Cao1014/2022_Smart_Car/README.md

# 2022 Smart Car
This repository includes the electrical designs of a smart car designed by in 2022.

(Note: _Computer Vision_ is not within the scope, sorry &#x1F915;)  
## Software:   
_Altium Designer_ 22.0.2 with student license  
_MDK-ARM 5.29.0.0_  default compiler version 5
## The whole design
Overall design of the car

 &nbsp; &nbsp; 

## Brushed DC Motor Control

#### Circuit Description

Brushed DC motor are commonly used in industrial applications such as robots, valves and healthcare equipment. When only one direction of rotation is required, a single switch topology with PWM modulation can be used to vary the voltage applied to the motor, and thus to control its speed. When positioning is required or when both directions of rotation are needed a full H-bridge with PWM control is used.  
This design adopts the _H-bridge_ structure to drive the brushed DC motor.
绘图2

**The circuit schematics and PCB layout are in the Altium folder.**  
**ESC codes are in the Codes folder.**
## Task Implementation

Obtaining the speed and angle of the car is the premise to realize the car's autonomous line tracking. The collected data form sensors are used in conjunction with the PID algorithm based on STM32. Through calculation, the control data via the PWM will be sent to the motor electronic speed controller to control speed of the motors. The whole mechanism is shown below

  

绘图1

**The circuit schematics and PCB layout are in the Altium folder.**  
**Codes for all patios are in the Codes folder.**
