Cao1014/2022_Smart_Car/(list of files, drawings)

Other design files:
Brushed_DCMotor_Control/Altium/MINI_ESC_G0.PrjPcb
Brushed_DCMotor_Control/Altium/MINI_ESC_V1.0.SchDoc
Tasks_Implementation/Altium/CHAS_CTRL_G0.PrjPcb
Tasks_Implementation/Altium/Main_Control_V1.1.SchDoc
