Cao1014/2022_Smart_Car/Tasks_Implementation/Codes/CHAS_G0_V2_Patio1/Core/Src/main.c

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
/* Includes ------------------------------------------------------------------*/
#include "main.h"
#include "rtc.h"
#include "spi.h"
#include "tim.h"
#include "usart.h"
#include "gpio.h"

/* USER CODE BEGIN Includes */
#include "usonic.h"
#include "motion.h"
#include "my_robot.h"
#include "nrf.h"
#include "elapse.h"
#include "stdio.h"
/* USER CODE END Includes */


/* USER CODE BEGIN PV */
extern IMU MyIMU;
extern ESC_COM G0;
extern NRF_COM MyNRF;
extern uint8_t Rx3Buffer[IMUBUFFERSIZE];
extern uint8_t Rx2Buffer[CVBUFFERSIZE];
extern uint8_t Rx1Buffer[BLBUFFERSIZE]; 

extern int16_t nrf_trans_cmd[7];         //转换后数据
extern uint8_t button[26];									//按键 

/* USER CODE END PV */

void SystemClock_Config(void);
/* USER CODE BEGIN 0 */
#ifdef __GNUC__
  /* With GCC/RAISONANCE, small printf (option LD Linker->Libraries->Small printf
     set to 'Yes') calls __io_putchar() */
  #define PUTCHAR_PROTOTYPE int __io_putchar(int ch)
#else
  #define PUTCHAR_PROTOTYPE int fputc(int ch, FILE *f)
#endif /* __GNUC__ */
/**
  * @brief  Retargets the C library printf function to the USART.
  * @param  None
  * @retval None
  */
PUTCHAR_PROTOTYPE
{
  /* Place your implementation of fputc here */
  /* e.g. write a character to the EVAL_COM1 and Loop until the end of transmission */
  HAL_UART_Transmit(&huart1, (uint8_t *)&ch, 1, 0xFFFF);//更具实际情况更改驱动
 
  return ch;
}
/* USER CODE END 0 */

/**
  * @brief  The application entry point.
  * @retval int
  */
int main(void)
{
  /* MCU Configuration--------------------------------------------------------*/

  /* Reset of all peripherals, Initializes the Flash interface and the Systick. */
   HAL_Init();

  /* Configure the system clock */
  SystemClock_Config();

  /* Initialize all configured peripherals */
  MX_GPIO_Init();
  MX_RTC_Init();
  MX_SPI2_Init();
  MX_TIM3_Init();
  MX_TIM14_Init();
  MX_TIM15_Init();
  MX_TIM16_Init();
  MX_TIM17_Init();
  MX_USART1_UART_Init();
  MX_USART2_UART_Init();
  MX_USART3_UART_Init();
  MX_USART4_UART_Init();
  MX_TIM7_Init();
  MX_TIM6_Init();
  /* USER CODE BEGIN 2 */
	IMU_Init();
	CV_init();
	LL_mDelay(50);
	TIM14->CCR1 = 5;//开启超声波
	TIM15->CCR2 = 55;
	
	IMU_Command(ANGLE_INIT);
	Angle_init(); //开启角度环
	nrf_init();	
//	RTC_Init(); //等待电脑数据

  /* USER CODE END 2 */

  /* Infinite loop */
  /* USER CODE BEGIN WHILE */
  while (1)
  {
    /* USER CODE END WHILE */

    /* USER CODE BEGIN 3 */
		IMU_Receive(Rx3Buffer);
		Mean_Filter();
		Car_Drive(MyNRF.Mode);

  }
  /* USER CODE END 3 */
}

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
