Cao1014/2022_Smart_Car/Tasks_Implementation/Codes/CHAS_G0_V2_Patio1/CHAS_G0_V2_Patio1.ioc

Mcu.UserName=STM32G070CBTx
PA0.Signal=USART4_TX
PA1.Signal=USART4_RX
PA13.Signal=SYS_SWDIO
PA14-BOOT0.Signal=SYS_SWCLK
PA2.Signal=USART2_TX
PA3.Signal=USART2_RX
PA4.Signal=S_TIM14_CH1
PA6.Signal=S_TIM3_CH1
PA7.Signal=S_TIM3_CH2
PB0.Signal=S_TIM3_CH3
PB1.Signal=S_TIM3_CH4
PB10.Signal=SPI2_SCK
PB11.Signal=SPI2_MOSI
PB12.GPIO_Label=NRF_IRQ
PB12.Signal=GPIO_Input
PB13.GPIO_Label=NRF_CE
PB13.Signal=GPIO_Output
PB14.GPIO_Label=NRF_CS
PB14.Signal=GPIO_Output
PB15.Signal=S_TIM15_CH2
PB2.Signal=SPI2_MISO
PB6.Signal=USART1_TX
PB7.Signal=USART1_RX
PB8.Signal=USART3_TX
PB9.Signal=USART3_RX
PD0.Signal=S_TIM16_CH1
PD1.Signal=S_TIM17_CH1
