Cao1014/2022_Smart_Car/Tasks_Implementation/Codes/CHAS_G0_V2_Patio1/Core/Inc/main.h

#define NRF_IRQ_Pin LL_GPIO_PIN_12
#define NRF_IRQ_GPIO_Port GPIOB
#define NRF_CE_Pin LL_GPIO_PIN_13
#define NRF_CE_GPIO_Port GPIOB
#define NRF_CS_Pin LL_GPIO_PIN_14
#define NRF_CS_GPIO_Port GPIOB
