Cao1014/2022_Smart_Car/Tasks_Implementation/Codes/CHAS_G0_V2_Patio1/Core/Src/tim.c

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
/* Includes ------------------------------------------------------------------*/
#include "tim.h"

/* TIM3 init function */
void MX_TIM3_Init(void)
{

  LL_TIM_InitTypeDef TIM_InitStruct = {0};
  LL_TIM_OC_InitTypeDef TIM_OC_InitStruct = {0};

  LL_RCC_LSE_SetDriveCapability(LL_RCC_LSEDRIVE_LOW);

  LL_GPIO_InitTypeDef GPIO_InitStruct = {0};
  /* Peripheral clock enable */
  LL_APB1_GRP1_EnableClock(LL_APB1_GRP1_PERIPH_TIM3);

  TIM_InitStruct.Prescaler = 639;
  TIM_InitStruct.CounterMode = LL_TIM_COUNTERMODE_UP;
  TIM_InitStruct.Autoreload = 999;
  TIM_InitStruct.ClockDivision = LL_TIM_CLOCKDIVISION_DIV1;
  LL_TIM_Init(TIM3, &TIM_InitStruct);
  LL_TIM_DisableARRPreload(TIM3);
  LL_TIM_OC_EnablePreload(TIM3, LL_TIM_CHANNEL_CH1);
  TIM_OC_InitStruct.OCMode = LL_TIM_OCMODE_PWM1;
  TIM_OC_InitStruct.OCState = LL_TIM_OCSTATE_DISABLE;
  TIM_OC_InitStruct.OCNState = LL_TIM_OCSTATE_DISABLE;
  TIM_OC_InitStruct.CompareValue = 0;
  TIM_OC_InitStruct.OCPolarity = LL_TIM_OCPOLARITY_HIGH;
  LL_TIM_OC_Init(TIM3, LL_TIM_CHANNEL_CH1, &TIM_OC_InitStruct);
  LL_TIM_OC_DisableFast(TIM3, LL_TIM_CHANNEL_CH1);
  LL_TIM_OC_EnablePreload(TIM3, LL_TIM_CHANNEL_CH2);
  LL_TIM_OC_Init(TIM3, LL_TIM_CHANNEL_CH2, &TIM_OC_InitStruct);
  LL_TIM_OC_DisableFast(TIM3, LL_TIM_CHANNEL_CH2);
  LL_TIM_OC_EnablePreload(TIM3, LL_TIM_CHANNEL_CH3);
  LL_TIM_OC_Init(TIM3, LL_TIM_CHANNEL_CH3, &TIM_OC_InitStruct);
  LL_TIM_OC_DisableFast(TIM3, LL_TIM_CHANNEL_CH3);
  LL_TIM_OC_EnablePreload(TIM3, LL_TIM_CHANNEL_CH4);
  LL_TIM_OC_Init(TIM3, LL_TIM_CHANNEL_CH4, &TIM_OC_InitStruct);
  LL_TIM_OC_DisableFast(TIM3, LL_TIM_CHANNEL_CH4);
  LL_TIM_SetTriggerOutput(TIM3, LL_TIM_TRGO_RESET);
  LL_TIM_DisableMasterSlaveMode(TIM3);
  /* USER CODE BEGIN TIM3_Init 2 */
	LL_TIM_CC_EnableChannel(TIM3,LL_TIM_CHANNEL_CH1);
	LL_TIM_CC_EnableChannel(TIM3,LL_TIM_CHANNEL_CH2);
	LL_TIM_CC_EnableChannel(TIM3,LL_TIM_CHANNEL_CH3);
	LL_TIM_CC_EnableChannel(TIM3,LL_TIM_CHANNEL_CH4);
	
	LL_TIM_EnableCounter(TIM3);
	LL_TIM_EnableAllOutputs(TIM3);
	
  /* USER CODE END TIM3_Init 2 */
  LL_IOP_GRP1_EnableClock(LL_IOP_GRP1_PERIPH_GPIOA);
  LL_IOP_GRP1_EnableClock(LL_IOP_GRP1_PERIPH_GPIOB);
    /**TIM3 GPIO Configuration
    PA6     ------> TIM3_CH1
    PA7     ------> TIM3_CH2
    PB0     ------> TIM3_CH3
    PB1     ------> TIM3_CH4
    */
  GPIO_InitStruct.Pin = LL_GPIO_PIN_6;
  GPIO_InitStruct.Mode = LL_GPIO_MODE_ALTERNATE;
  GPIO_InitStruct.Speed = LL_GPIO_SPEED_FREQ_LOW;
  GPIO_InitStruct.OutputType = LL_GPIO_OUTPUT_PUSHPULL;
  GPIO_InitStruct.Pull = LL_GPIO_PULL_NO;
  GPIO_InitStruct.Alternate = LL_GPIO_AF_1;
  LL_GPIO_Init(GPIOA, &GPIO_InitStruct);

  GPIO_InitStruct.Pin = LL_GPIO_PIN_7;
  GPIO_InitStruct.Mode = LL_GPIO_MODE_ALTERNATE;
  GPIO_InitStruct.Speed = LL_GPIO_SPEED_FREQ_LOW;
  GPIO_InitStruct.OutputType = LL_GPIO_OUTPUT_PUSHPULL;
  GPIO_InitStruct.Pull = LL_GPIO_PULL_NO;
  GPIO_InitStruct.Alternate = LL_GPIO_AF_1;
  LL_GPIO_Init(GPIOA, &GPIO_InitStruct);

  GPIO_InitStruct.Pin = LL_GPIO_PIN_0;
  GPIO_InitStruct.Mode = LL_GPIO_MODE_ALTERNATE;
  GPIO_InitStruct.Speed = LL_GPIO_SPEED_FREQ_LOW;
  GPIO_InitStruct.OutputType = LL_GPIO_OUTPUT_PUSHPULL;
  GPIO_InitStruct.Pull = LL_GPIO_PULL_NO;
  GPIO_InitStruct.Alternate = LL_GPIO_AF_1;
  LL_GPIO_Init(GPIOB, &GPIO_InitStruct);

  GPIO_InitStruct.Pin = LL_GPIO_PIN_1;
  GPIO_InitStruct.Mode = LL_GPIO_MODE_ALTERNATE;
  GPIO_InitStruct.Speed = LL_GPIO_SPEED_FREQ_LOW;
  GPIO_InitStruct.OutputType = LL_GPIO_OUTPUT_PUSHPULL;
  GPIO_InitStruct.Pull = LL_GPIO_PULL_NO;
  GPIO_InitStruct.Alternate = LL_GPIO_AF_1;
  LL_GPIO_Init(GPIOB, &GPIO_InitStruct);

}
/* TIM6 init function */
void MX_TIM6_Init(void)
{

  LL_TIM_InitTypeDef TIM_InitStruct = {0};

  LL_RCC_LSE_SetDriveCapability(LL_RCC_LSEDRIVE_LOW);

  /* Peripheral clock enable */
  LL_APB1_GRP1_EnableClock(LL_APB1_GRP1_PERIPH_TIM6);

  /* TIM6 interrupt Init */
  NVIC_SetPriority(TIM6_IRQn, 0);
  NVIC_EnableIRQ(TIM6_IRQn);

  TIM_InitStruct.Prescaler = 6399;
  TIM_InitStruct.CounterMode = LL_TIM_COUNTERMODE_UP;
  TIM_InitStruct.Autoreload = 999;
  LL_TIM_Init(TIM6, &TIM_InitStruct);
  LL_TIM_DisableARRPreload(TIM6);
  LL_TIM_SetTriggerOutput(TIM6, LL_TIM_TRGO_RESET);
  LL_TIM_DisableMasterSlaveMode(TIM6);
  /* USER CODE BEGIN TIM6_Init 2 */
	LL_TIM_EnableIT_UPDATE(TIM6);//开启中断
	LL_TIM_EnableCounter(TIM6);
  /* USER CODE END TIM6_Init 2 */

}
/* TIM7 init function */
void MX_TIM7_Init(void)
{

  LL_TIM_InitTypeDef TIM_InitStruct = {0};

  LL_RCC_LSE_SetDriveCapability(LL_RCC_LSEDRIVE_LOW);

  /* Peripheral clock enable */
  LL_APB1_GRP1_EnableClock(LL_APB1_GRP1_PERIPH_TIM7);

  /* TIM7 interrupt Init */
  NVIC_SetPriority(TIM7_IRQn, 0);
  NVIC_EnableIRQ(TIM7_IRQn);

  TIM_InitStruct.Prescaler = 639;
  TIM_InitStruct.CounterMode = LL_TIM_COUNTERMODE_UP;
  TIM_InitStruct.Autoreload = 1999;
  LL_TIM_Init(TIM7, &TIM_InitStruct);
  LL_TIM_DisableARRPreload(TIM7);
  LL_TIM_SetTriggerOutput(TIM7, LL_TIM_TRGO_RESET);
  LL_TIM_DisableMasterSlaveMode(TIM7);
  /* USER CODE BEGIN TIM7_Init 2 */
	
	LL_TIM_EnableCounter(TIM7);
	
  /* USER CODE END TIM7_Init 2 */

}
/* TIM14 init function */
void MX_TIM14_Init(void)
{

  LL_TIM_InitTypeDef TIM_InitStruct = {0};
  LL_TIM_OC_InitTypeDef TIM_OC_InitStruct = {0};

  LL_RCC_LSE_SetDriveCapability(LL_RCC_LSEDRIVE_LOW);

  LL_GPIO_InitTypeDef GPIO_InitStruct = {0};
  /* Peripheral clock enable */
  LL_APB2_GRP1_EnableClock(LL_APB2_GRP1_PERIPH_TIM14);

  /* TIM14 interrupt Init */
  NVIC_SetPriority(TIM14_IRQn, 2);
  NVIC_EnableIRQ(TIM14_IRQn);

  TIM_InitStruct.Prescaler = 639;
  TIM_InitStruct.CounterMode = LL_TIM_COUNTERMODE_UP;
  TIM_InitStruct.Autoreload = 6999;
  TIM_InitStruct.ClockDivision = LL_TIM_CLOCKDIVISION_DIV1;
  LL_TIM_Init(TIM14, &TIM_InitStruct);
  LL_TIM_DisableARRPreload(TIM14);
  LL_TIM_OC_EnablePreload(TIM14, LL_TIM_CHANNEL_CH1);
  TIM_OC_InitStruct.OCMode = LL_TIM_OCMODE_PWM1;
  TIM_OC_InitStruct.OCState = LL_TIM_OCSTATE_DISABLE;
  TIM_OC_InitStruct.OCNState = LL_TIM_OCSTATE_DISABLE;
  TIM_OC_InitStruct.CompareValue = 0;
  TIM_OC_InitStruct.OCPolarity = LL_TIM_OCPOLARITY_HIGH;
  LL_TIM_OC_Init(TIM14, LL_TIM_CHANNEL_CH1, &TIM_OC_InitStruct);
  LL_TIM_OC_DisableFast(TIM14, LL_TIM_CHANNEL_CH1);
  /* USER CODE BEGIN TIM14_Init 2 */
	LL_TIM_CC_EnableChannel(TIM14,LL_TIM_CHANNEL_CH1);
	
	if (LL_TIM_CC_IsEnabledChannel(TIM14, LL_TIM_CHANNEL_CH1) != 01U)
  {
    /* PWM Generation Error */
    Error_Handler();
  }
	
	LL_TIM_EnableCounter(TIM14);
	LL_TIM_EnableAllOutputs(TIM14);
	
  /* USER CODE END TIM14_Init 2 */
  LL_IOP_GRP1_EnableClock(LL_IOP_GRP1_PERIPH_GPIOA);
    /**TIM14 GPIO Configuration
    PA4     ------> TIM14_CH1
    */
  GPIO_InitStruct.Pin = LL_GPIO_PIN_4;
  GPIO_InitStruct.Mode = LL_GPIO_MODE_ALTERNATE;
  GPIO_InitStruct.Speed = LL_GPIO_SPEED_FREQ_LOW;
  GPIO_InitStruct.OutputType = LL_GPIO_OUTPUT_PUSHPULL;
  GPIO_InitStruct.Pull = LL_GPIO_PULL_NO;
  GPIO_InitStruct.Alternate = LL_GPIO_AF_4;
  LL_GPIO_Init(GPIOA, &GPIO_InitStruct);

}
/* TIM15 init function */
void MX_TIM15_Init(void)
{

  LL_TIM_InitTypeDef TIM_InitStruct = {0};
  LL_TIM_OC_InitTypeDef TIM_OC_InitStruct = {0};
  LL_TIM_BDTR_InitTypeDef TIM_BDTRInitStruct = {0};

  LL_RCC_LSE_SetDriveCapability(LL_RCC_LSEDRIVE_LOW);

  LL_GPIO_InitTypeDef GPIO_InitStruct = {0};
  /* Peripheral clock enable */
  LL_APB2_GRP1_EnableClock(LL_APB2_GRP1_PERIPH_TIM15);

  /* TIM15 interrupt Init */
  NVIC_SetPriority(TIM15_IRQn, 1);
  NVIC_EnableIRQ(TIM15_IRQn);

  TIM_InitStruct.Prescaler = 639;
  TIM_InitStruct.CounterMode = LL_TIM_COUNTERMODE_UP;
  TIM_InitStruct.Autoreload = 1999;
  TIM_InitStruct.ClockDivision = LL_TIM_CLOCKDIVISION_DIV1;
  TIM_InitStruct.RepetitionCounter = 0;
  LL_TIM_Init(TIM15, &TIM_InitStruct);
  LL_TIM_DisableARRPreload(TIM15);
  LL_TIM_OC_EnablePreload(TIM15, LL_TIM_CHANNEL_CH2);
  TIM_OC_InitStruct.OCMode = LL_TIM_OCMODE_PWM1;
  TIM_OC_InitStruct.OCState = LL_TIM_OCSTATE_DISABLE;
  TIM_OC_InitStruct.OCNState = LL_TIM_OCSTATE_DISABLE;
  TIM_OC_InitStruct.CompareValue = 0;
  TIM_OC_InitStruct.OCPolarity = LL_TIM_OCPOLARITY_HIGH;
  TIM_OC_InitStruct.OCNPolarity = LL_TIM_OCPOLARITY_HIGH;
  TIM_OC_InitStruct.OCIdleState = LL_TIM_OCIDLESTATE_LOW;
  TIM_OC_InitStruct.OCNIdleState = LL_TIM_OCIDLESTATE_LOW;
  LL_TIM_OC_Init(TIM15, LL_TIM_CHANNEL_CH2, &TIM_OC_InitStruct);
  LL_TIM_OC_DisableFast(TIM15, LL_TIM_CHANNEL_CH2);
  LL_TIM_SetTriggerOutput(TIM15, LL_TIM_TRGO_RESET);
  LL_TIM_DisableMasterSlaveMode(TIM15);
  TIM_BDTRInitStruct.OSSRState = LL_TIM_OSSR_DISABLE;
  TIM_BDTRInitStruct.OSSIState = LL_TIM_OSSI_DISABLE;
  TIM_BDTRInitStruct.LockLevel = LL_TIM_LOCKLEVEL_OFF;
  TIM_BDTRInitStruct.DeadTime = 0;
  TIM_BDTRInitStruct.BreakState = LL_TIM_BREAK_DISABLE;
  TIM_BDTRInitStruct.BreakPolarity = LL_TIM_BREAK_POLARITY_HIGH;
  TIM_BDTRInitStruct.BreakFilter = LL_TIM_BREAK_FILTER_FDIV1;
  TIM_BDTRInitStruct.AutomaticOutput = LL_TIM_AUTOMATICOUTPUT_DISABLE;
  LL_TIM_BDTR_Init(TIM15, &TIM_BDTRInitStruct);
  /* USER CODE BEGIN TIM15_Init 2 */
	LL_TIM_CC_EnableChannel(TIM15,LL_TIM_CHANNEL_CH2);
	
	LL_TIM_EnableCounter(TIM15);
	LL_TIM_EnableAllOutputs(TIM15);
	
	LL_TIM_EnableIT_UPDATE(TIM15);//开启中断
  /* USER CODE END TIM15_Init 2 */
  LL_IOP_GRP1_EnableClock(LL_IOP_GRP1_PERIPH_GPIOB);
    /**TIM15 GPIO Configuration
    PB15     ------> TIM15_CH2
    */
  GPIO_InitStruct.Pin = LL_GPIO_PIN_15;
  GPIO_InitStruct.Mode = LL_GPIO_MODE_ALTERNATE;
  GPIO_InitStruct.Speed = LL_GPIO_SPEED_FREQ_LOW;
  GPIO_InitStruct.OutputType = LL_GPIO_OUTPUT_PUSHPULL;
  GPIO_InitStruct.Pull = LL_GPIO_PULL_NO;
  GPIO_InitStruct.Alternate = LL_GPIO_AF_5;
  LL_GPIO_Init(GPIOB, &GPIO_InitStruct);

}
/* TIM16 init function */
void MX_TIM16_Init(void)
{

  LL_TIM_InitTypeDef TIM_InitStruct = {0};

  LL_GPIO_InitTypeDef GPIO_InitStruct = {0};

  LL_RCC_LSE_SetDriveCapability(LL_RCC_LSEDRIVE_LOW);

  /* Peripheral clock enable */
  LL_APB2_GRP1_EnableClock(LL_APB2_GRP1_PERIPH_TIM16);

  LL_IOP_GRP1_EnableClock(LL_IOP_GRP1_PERIPH_GPIOD);
  /**TIM16 GPIO Configuration
  PD0   ------> TIM16_CH1
  */
  GPIO_InitStruct.Pin = LL_GPIO_PIN_0;
  GPIO_InitStruct.Mode = LL_GPIO_MODE_ALTERNATE;
  GPIO_InitStruct.Speed = LL_GPIO_SPEED_FREQ_LOW;
  GPIO_InitStruct.OutputType = LL_GPIO_OUTPUT_PUSHPULL;
  GPIO_InitStruct.Pull = LL_GPIO_PULL_NO;
  GPIO_InitStruct.Alternate = LL_GPIO_AF_2;
  LL_GPIO_Init(GPIOD, &GPIO_InitStruct);

  /* TIM16 interrupt Init */
  NVIC_SetPriority(TIM16_IRQn, 1);
  NVIC_EnableIRQ(TIM16_IRQn);

  TIM_InitStruct.Prescaler = 639;
  TIM_InitStruct.CounterMode = LL_TIM_COUNTERMODE_UP;
  TIM_InitStruct.Autoreload = 8999;
  TIM_InitStruct.ClockDivision = LL_TIM_CLOCKDIVISION_DIV1;
  TIM_InitStruct.RepetitionCounter = 0;
  LL_TIM_Init(TIM16, &TIM_InitStruct);
  LL_TIM_DisableARRPreload(TIM16);
  LL_TIM_IC_SetActiveInput(TIM16, LL_TIM_CHANNEL_CH1, LL_TIM_ACTIVEINPUT_DIRECTTI);
  LL_TIM_IC_SetPrescaler(TIM16, LL_TIM_CHANNEL_CH1, LL_TIM_ICPSC_DIV1);
  LL_TIM_IC_SetFilter(TIM16, LL_TIM_CHANNEL_CH1, LL_TIM_IC_FILTER_FDIV32_N8);
  LL_TIM_IC_SetPolarity(TIM16, LL_TIM_CHANNEL_CH1, LL_TIM_IC_POLARITY_RISING);
  /* USER CODE BEGIN TIM16_Init 2 */
	LL_TIM_CC_EnableChannel(TIM16,LL_TIM_CHANNEL_CH1);
	
	LL_TIM_EnableIT_CC1(TIM16);
	LL_TIM_EnableCounter(TIM16);
	
	LL_TIM_ClearFlag_CC1(TIM16);
  /* USER CODE END TIM16_Init 2 */

}
/* TIM17 init function */
void MX_TIM17_Init(void)
{

  LL_TIM_InitTypeDef TIM_InitStruct = {0};

  LL_GPIO_InitTypeDef GPIO_InitStruct = {0};

  LL_RCC_LSE_SetDriveCapability(LL_RCC_LSEDRIVE_LOW);

  /* Peripheral clock enable */
  LL_APB2_GRP1_EnableClock(LL_APB2_GRP1_PERIPH_TIM17);

  LL_IOP_GRP1_EnableClock(LL_IOP_GRP1_PERIPH_GPIOD);
  /**TIM17 GPIO Configuration
  PD1   ------> TIM17_CH1
  */
  GPIO_InitStruct.Pin = LL_GPIO_PIN_1;
  GPIO_InitStruct.Mode = LL_GPIO_MODE_ALTERNATE;
  GPIO_InitStruct.Speed = LL_GPIO_SPEED_FREQ_LOW;
  GPIO_InitStruct.OutputType = LL_GPIO_OUTPUT_PUSHPULL;
  GPIO_InitStruct.Pull = LL_GPIO_PULL_NO;
  GPIO_InitStruct.Alternate = LL_GPIO_AF_2;
  LL_GPIO_Init(GPIOD, &GPIO_InitStruct);

  /* TIM17 interrupt Init */
  NVIC_SetPriority(TIM17_IRQn, 1);
  NVIC_EnableIRQ(TIM17_IRQn);

  TIM_InitStruct.Prescaler = 639;
  TIM_InitStruct.CounterMode = LL_TIM_COUNTERMODE_UP;
  TIM_InitStruct.Autoreload = 8999;
  TIM_InitStruct.ClockDivision = LL_TIM_CLOCKDIVISION_DIV1;
  TIM_InitStruct.RepetitionCounter = 0;
  LL_TIM_Init(TIM17, &TIM_InitStruct);
  LL_TIM_DisableARRPreload(TIM17);
  LL_TIM_IC_SetActiveInput(TIM17, LL_TIM_CHANNEL_CH1, LL_TIM_ACTIVEINPUT_DIRECTTI);
  LL_TIM_IC_SetPrescaler(TIM17, LL_TIM_CHANNEL_CH1, LL_TIM_ICPSC_DIV1);
  LL_TIM_IC_SetFilter(TIM17, LL_TIM_CHANNEL_CH1, LL_TIM_IC_FILTER_FDIV32_N8);
  LL_TIM_IC_SetPolarity(TIM17, LL_TIM_CHANNEL_CH1, LL_TIM_IC_POLARITY_RISING);
  /* USER CODE BEGIN TIM17_Init 2 */
	LL_TIM_CC_EnableChannel(TIM17,LL_TIM_CHANNEL_CH1);
	
	LL_TIM_EnableIT_CC1(TIM17);
	LL_TIM_EnableCounter(TIM17);
	
	LL_TIM_ClearFlag_CC1(TIM17);
  /* USER CODE END TIM17_Init 2 */

}
