Cao1014/2022_Smart_Car/Brushed_DCMotor_Control/Codes/MINI_ESC_G0/Core/Src/adc.c

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
/* Includes ------------------------------------------------------------------*/
#include "adc.h"

/* USER CODE BEGIN 0 */
short aADCxConvertedData[ADC_CONVERTED_DATA_BUFFER_SIZE];


/* USER CODE END 0 */

/* ADC1 init function */
void MX_ADC1_Init(void)
{

  LL_ADC_InitTypeDef ADC_InitStruct = {0};
  LL_ADC_REG_InitTypeDef ADC_REG_InitStruct = {0};

  LL_GPIO_InitTypeDef GPIO_InitStruct = {0};

  LL_RCC_SetADCClockSource(LL_RCC_ADC_CLKSOURCE_SYSCLK);

  /* Peripheral clock enable */
  LL_APB2_GRP1_EnableClock(LL_APB2_GRP1_PERIPH_ADC);

  LL_IOP_GRP1_EnableClock(LL_IOP_GRP1_PERIPH_GPIOA);
  /**ADC1 GPIO Configuration
  PA0   ------> ADC1_IN0
  */
  GPIO_InitStruct.Pin = LL_GPIO_PIN_0;
  GPIO_InitStruct.Mode = LL_GPIO_MODE_ANALOG;
  GPIO_InitStruct.Pull = LL_GPIO_PULL_NO;
  LL_GPIO_Init(GPIOA, &GPIO_InitStruct);

  /* ADC1 DMA Init */

  /* ADC1 Init */
  LL_DMA_SetPeriphRequest(DMA1, LL_DMA_CHANNEL_1, LL_DMAMUX_REQ_ADC1);

  LL_DMA_SetDataTransferDirection(DMA1, LL_DMA_CHANNEL_1, LL_DMA_DIRECTION_PERIPH_TO_MEMORY);

  LL_DMA_SetChannelPriorityLevel(DMA1, LL_DMA_CHANNEL_1, LL_DMA_PRIORITY_HIGH);

  LL_DMA_SetMode(DMA1, LL_DMA_CHANNEL_1, LL_DMA_MODE_CIRCULAR);

  LL_DMA_SetPeriphIncMode(DMA1, LL_DMA_CHANNEL_1, LL_DMA_PERIPH_NOINCREMENT);

  LL_DMA_SetMemoryIncMode(DMA1, LL_DMA_CHANNEL_1, LL_DMA_MEMORY_NOINCREMENT);

  LL_DMA_SetPeriphSize(DMA1, LL_DMA_CHANNEL_1, LL_DMA_PDATAALIGN_HALFWORD);

  LL_DMA_SetMemorySize(DMA1, LL_DMA_CHANNEL_1, LL_DMA_MDATAALIGN_HALFWORD);

  /* USER CODE BEGIN ADC1_Init 1 */
	
	 /* Set DMA transfer addresses of source and destination */
  LL_DMA_ConfigAddresses(DMA1,
                        LL_DMA_CHANNEL_1,
                         LL_ADC_DMA_GetRegAddr(ADC1, LL_ADC_DMA_REG_REGULAR_DATA),
                         (uint32_t)&aADCxConvertedData,
                         LL_DMA_DIRECTION_PERIPH_TO_MEMORY);
  
  /* Set DMA transfer size */
  LL_DMA_SetDataLength(DMA1,
                        LL_DMA_CHANNEL_1,
                       ADC_CONVERTED_DATA_BUFFER_SIZE);	
	
//	LL_DMA_SetDataLength(DMA1,LL_DMA_CHANNEL_1,ADC_CONVERTED_DATA_BUFFER_SIZE);
//	LL_DMA_SetPeriphAddress(DMA1,LL_DMA_CHANNEL_1,LL_ADC_DMA_GetRegAddr(ADC1,LL_ADC_DMA_REG_REGULAR_DATA));
//	LL_DMA_SetMemoryAddress(DMA1,LL_DMA_CHANNEL_1,(uint32_t)aADCxConvertedData);
	
	/*## Activation of DMA #####################################################*/
  /* Enable the DMA transfer */

  LL_DMA_EnableChannel(DMA1,LL_DMA_CHANNEL_1);
  /* USER CODE END ADC1_Init 1 */

  /** Configure the global features of the ADC (Clock, Resolution, Data Alignment and number of conversion)
  */

   #define ADC_CHANNEL_CONF_RDY_TIMEOUT_MS ( 1U)
   #if (USE_TIMEOUT == 1)
   uint32_t Timeout ; /* Variable used for Timeout management */
   #endif /* USE_TIMEOUT */

  ADC_InitStruct.Clock = LL_ADC_CLOCK_SYNC_PCLK_DIV2;
  ADC_InitStruct.Resolution = LL_ADC_RESOLUTION_12B;
  ADC_InitStruct.DataAlignment = LL_ADC_DATA_ALIGN_RIGHT;
  ADC_InitStruct.LowPowerMode = LL_ADC_LP_MODE_NONE;
  LL_ADC_Init(ADC1, &ADC_InitStruct);
  LL_ADC_REG_SetSequencerConfigurable(ADC1, LL_ADC_REG_SEQ_CONFIGURABLE);

   /* Poll for ADC channel configuration ready */
   #if (USE_TIMEOUT == 1)
   Timeout = ADC_CHANNEL_CONF_RDY_TIMEOUT_MS;
   #endif /* USE_TIMEOUT */
   while (LL_ADC_IsActiveFlag_CCRDY(ADC1) == 0)
     {
   #if (USE_TIMEOUT == 1)
   /* Check Systick counter flag to decrement the time-out value */
   if (LL_SYSTICK_IsActiveCounterFlag())
     {
   if(Timeout-- == 0)
         {
   Error_Handler();
         }
     }
   #endif /* USE_TIMEOUT */
     }
   /* Clear flag ADC channel configuration ready */
   LL_ADC_ClearFlag_CCRDY(ADC1);
  ADC_REG_InitStruct.TriggerSource = LL_ADC_REG_TRIG_SOFTWARE;
  ADC_REG_InitStruct.SequencerLength = LL_ADC_REG_SEQ_SCAN_DISABLE;
  ADC_REG_InitStruct.ContinuousMode = LL_ADC_REG_CONV_CONTINUOUS;
  ADC_REG_InitStruct.DMATransfer = LL_ADC_REG_DMA_TRANSFER_UNLIMITED;
  ADC_REG_InitStruct.Overrun = LL_ADC_REG_OVR_DATA_PRESERVED;
  LL_ADC_REG_Init(ADC1, &ADC_REG_InitStruct);
  LL_ADC_SetOverSamplingScope(ADC1, LL_ADC_OVS_DISABLE);
  LL_ADC_SetTriggerFrequencyMode(ADC1, LL_ADC_CLOCK_FREQ_MODE_HIGH);
  LL_ADC_SetSamplingTimeCommonChannels(ADC1, LL_ADC_SAMPLINGTIME_COMMON_1, LL_ADC_SAMPLINGTIME_12CYCLES_5);
  LL_ADC_SetSamplingTimeCommonChannels(ADC1, LL_ADC_SAMPLINGTIME_COMMON_2, LL_ADC_SAMPLINGTIME_7CYCLES_5);
  LL_ADC_DisableIT_EOC(ADC1);
  LL_ADC_DisableIT_EOS(ADC1);

   /* Enable ADC internal voltage regulator */
   LL_ADC_EnableInternalRegulator(ADC1);
   /* Delay for ADC internal voltage regulator stabilization. */
   /* Compute number of CPU cycles to wait for, from delay in us. */
   /* Note: Variable divided by 2 to compensate partially */
   /* CPU processing cycles (depends on compilation optimization). */
   /* Note: If system core clock frequency is below 200kHz, wait time */
   /* is only a few CPU processing cycles. */
   uint32_t wait_loop_index;
   wait_loop_index = ((LL_ADC_DELAY_INTERNAL_REGUL_STAB_US * (SystemCoreClock / (100000 * 2))) / 10);
   while(wait_loop_index != 0)
     {
   wait_loop_index--;
     }

  /** Configure Regular Channel
  */
  LL_ADC_REG_SetSequencerRanks(ADC1, LL_ADC_REG_RANK_1, LL_ADC_CHANNEL_0);
  LL_ADC_SetChannelSamplingTime(ADC1, LL_ADC_CHANNEL_0, LL_ADC_SAMPLINGTIME_COMMON_1);
  /* USER CODE BEGIN ADC1_Init 2 */
		 
	LL_ADC_REG_SetDMATransfer(ADC1,LL_ADC_REG_DMA_TRANSFER_NONE);
	/*     On this STM32 serie, ADC DMA transfer request should be disabled
         during calibration:																						 */
	/* ###  Start calibration ############################################ */
	LL_ADC_StartCalibration(ADC1);																			 

	// 等待校准完成
	while(LL_ADC_IsCalibrationOnGoing(ADC1))
	{
		LL_GPIO_TogglePin(GPIOC,GPIO_PIN_14);
		LL_mDelay(20);
	}
		LL_GPIO_TogglePin(GPIOC,GPIO_PIN_14);
		LL_mDelay(20);
	/* ### Start conversion in DMA mode ################################# */
		
	LL_ADC_Enable(ADC1);
	
	LL_ADC_REG_SetDMATransfer(ADC1,LL_ADC_REG_DMA_TRANSFER_UNLIMITED);
 
	LL_ADC_REG_StartConversion(ADC1); //对于F0系列的芯片需要加上这句代码
	
	
	LL_mDelay(2); //延时2ms，避免DMA读取数据通道不对
  /* USER CODE END ADC1_Init 2 */

}
