Cao1014/2022_Smart_Car/Tasks_Implementation/Codes/CHAS_G0_V2_Patio1/Core/Src/rtc.c

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
/* Includes ------------------------------------------------------------------*/
#include "rtc.h"

/* USER CODE BEGIN 0 */
#include "usart.h"
#include "elapse.h"

extern RTC_DateTypeDef UARTDate;  	//电脑日期结构体
extern RTC_TimeTypeDef UARTTime;   //电脑时间结构体

extern uint8_t Rx1Buffer[BLBUFFERSIZE]; 
/* USER CODE END 0 */

RTC_HandleTypeDef hrtc;

/* RTC init function */
void MX_RTC_Init(void)
{

  RTC_TimeTypeDef sTime = {0};
  RTC_DateTypeDef sDate = {0};

  /** Initialize RTC Only
  */
  hrtc.Instance = RTC;
  hrtc.Init.HourFormat = RTC_HOURFORMAT_24;
  hrtc.Init.AsynchPrediv = 127;
  hrtc.Init.SynchPrediv = 255;
  hrtc.Init.OutPut = RTC_OUTPUT_DISABLE;
  hrtc.Init.OutPutRemap = RTC_OUTPUT_REMAP_NONE;
  hrtc.Init.OutPutPolarity = RTC_OUTPUT_POLARITY_HIGH;
  hrtc.Init.OutPutType = RTC_OUTPUT_TYPE_OPENDRAIN;
  hrtc.Init.OutPutPullUp = RTC_OUTPUT_PULLUP_NONE;
  if (HAL_RTC_Init(&hrtc) != HAL_OK)
  {
    Error_Handler();
  }

  /** Initialize RTC and set the Time and Date
  */
  sTime.Hours = 0x5;
  sTime.Minutes = 0x0;
  sTime.Seconds = 0x0;
  sTime.SubSeconds = 0x0;
  sTime.DayLightSaving = RTC_DAYLIGHTSAVING_NONE;
  sTime.StoreOperation = RTC_STOREOPERATION_RESET;
  if (HAL_RTC_SetTime(&hrtc, &sTime, RTC_FORMAT_BCD) != HAL_OK)
  {
    Error_Handler();
  }
  sDate.WeekDay = RTC_WEEKDAY_TUESDAY;
  sDate.Month = RTC_MONTH_JUNE;
  sDate.Date = 0x1;
  sDate.Year = 0x22;

  if (HAL_RTC_SetDate(&hrtc, &sDate, RTC_FORMAT_BCD) != HAL_OK)
  {
    Error_Handler();
  }

  /** Enable the WakeUp
  */
  if (HAL_RTCEx_SetWakeUpTimer_IT(&hrtc, 512, RTC_WAKEUPCLOCK_RTCCLK_DIV16) != HAL_OK)
  {
    Error_Handler();
  }
  /* USER CODE BEGIN RTC_Init 2 */
	__HAL_RTC_WAKEUPTIMER_ENABLE(&hrtc);
	__HAL_RTC_WAKEUPTIMER_ENABLE_IT(&hrtc,RTC_IT_WUT);
	
  /* USER CODE END RTC_Init 2 */

}

void HAL_RTC_MspInit(RTC_HandleTypeDef* rtcHandle)
{

  if(rtcHandle->Instance==RTC)
  {
  if(LL_RCC_GetRTCClockSource() != LL_RCC_RTC_CLKSOURCE_LSE)
  {
    FlagStatus pwrclkchanged = RESET;
    /* Update LSE configuration in Backup Domain control register */
    /* Requires to enable write access to Backup Domain if necessary */
    if (LL_APB1_GRP1_IsEnabledClock (LL_APB1_GRP1_PERIPH_PWR) != 1U)
    {
      /* Enables the PWR Clock and Enables access to the backup domain */
      LL_APB1_GRP1_EnableClock(LL_APB1_GRP1_PERIPH_PWR);
      pwrclkchanged = SET;
    }
    if (LL_PWR_IsEnabledBkUpAccess () != 1U)
    {
      /* Enable write access to Backup domain */
      LL_PWR_EnableBkUpAccess();
      while (LL_PWR_IsEnabledBkUpAccess () == 0U)
      {
      }
    }
    LL_RCC_ForceBackupDomainReset();
    LL_RCC_ReleaseBackupDomainReset();
    LL_RCC_LSE_SetDriveCapability(LL_RCC_LSEDRIVE_LOW);
    LL_RCC_LSE_Enable();

   /* Wait till LSE is ready */
    while(LL_RCC_LSE_IsReady() != 1)
    {
    }
    LL_RCC_SetRTCClockSource(LL_RCC_RTC_CLKSOURCE_LSE);
    /* Restore clock configuration if changed */
    if (pwrclkchanged == SET)
    {
      LL_APB1_GRP1_DisableClock(LL_APB1_GRP1_PERIPH_PWR);
    }
  }

    /* RTC clock enable */
    __HAL_RCC_RTC_ENABLE();
    __HAL_RCC_RTCAPB_CLK_ENABLE();

    /* RTC interrupt Init */
    HAL_NVIC_SetPriority(RTC_TAMP_IRQn, 0, 0);
    HAL_NVIC_EnableIRQ(RTC_TAMP_IRQn);
  }
}

void HAL_RTC_MspDeInit(RTC_HandleTypeDef* rtcHandle)
{

  if(rtcHandle->Instance==RTC)
  {
    /* Peripheral clock disable */
    __HAL_RCC_RTC_DISABLE();
    __HAL_RCC_RTCAPB_CLK_DISABLE();

    /* RTC interrupt Deinit */
    HAL_NVIC_DisableIRQ(RTC_TAMP_IRQn);
  }
}

/* USER CODE BEGIN 1 */
void RTC_Init(void)
{
	while(UARTDate.Year == 0) BL_Receive(Rx1Buffer);
	

  UARTTime.SubSeconds = 0x0;
  UARTTime.DayLightSaving = RTC_DAYLIGHTSAVING_NONE;
  UARTTime.StoreOperation = RTC_STOREOPERATION_RESET;
	
  if (HAL_RTC_SetTime(&hrtc, &UARTTime, RTC_FORMAT_BCD) != HAL_OK)
  {
    Error_Handler();
  }
	
  if (HAL_RTC_SetDate(&hrtc, &UARTDate, RTC_FORMAT_BCD) != HAL_OK)
  {
    Error_Handler();
  }
	
//	LL_TIM_EnableIT_UPDATE(TIM14);//开启中断
}
/* USER CODE END 1 */
