Cao1014/2022_Smart_Car/(commit log)

2022-12-30 Uploaded BDC ESC
    [MINI_ESC_G0.PrjPcb, MINI_ESC_V1.0.SchDoc]
2022-12-30 Uploaded Main Control Board and MDK5 codes
    [CHAS_CTRL_G0.PrjPcb, Main_Control_V1.1.SchDoc]
