Cao1014/2022_Smart_Car/(notices)

Notices in the files:
Brushed_DCMotor_Control/Codes/MINI_ESC_G0/Core/Src/adc.c:
Copyright (c) 2022 STMicroelectronics.
All rights reserved.
This software is licensed under terms that can be found in the LICENSE file
